tact1m4n3/eprinter/pcb/eprinter.kicad_pcb

## KiCad design pcb/eprinter.kicad_pcb (2026-11-06)

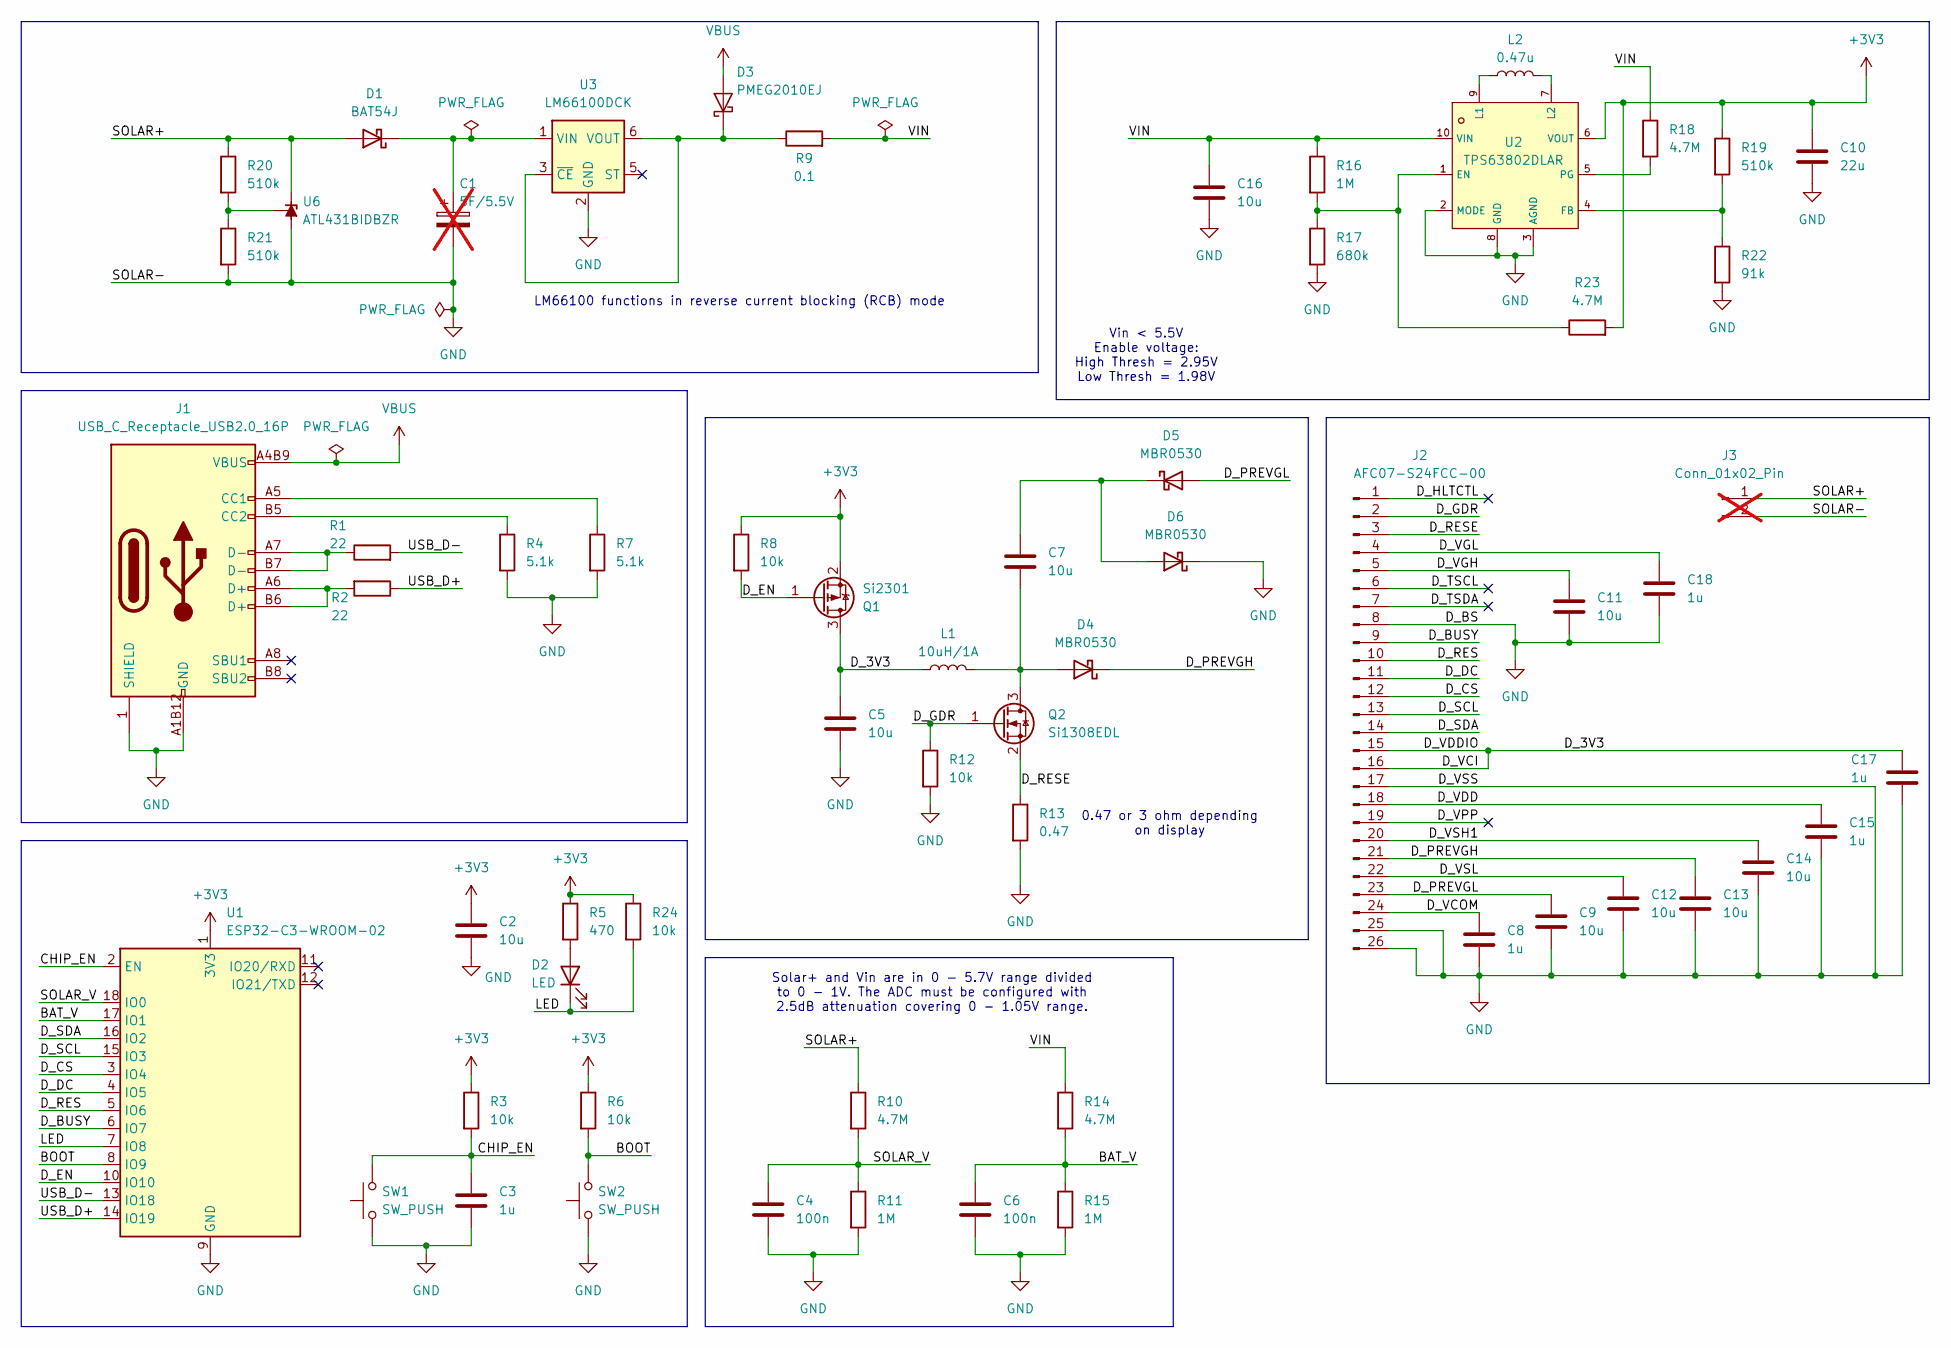
[picture p1: schematic eprinter.kicad_sch]

Parts:
C1: 5F/5.5V; THT_SUPERCAP; not fitted
C2, C5, C7, C9, C11, C12, C13, C14, C16: 10u; C_0805_2012Metric; LCSC C440198
C3, C8, C15, C17, C18: 1u; C_0603_1608Metric; LCSC C15849
C4, C6: 100n; C_0603_1608Metric; LCSC C14663
C10: 22u; C_0805_2012Metric; LCSC C45783
D1: BAT54J; D_SOD-323F; LCSC C130415
D2: LED; LED_0603_1608Metric; LCSC C2286
D3: PMEG2010EJ; D_SOD-323F; LCSC C552826
D4, D5, D6: MBR0530; D_SOD-123; LCSC C82046
J1: USB_C_Receptacle_USB2.0_16P; USB-C_SMD-TYPE-C-31-M-12_1; LCSC C165948
J2: AFC07-S24FCC-00; FPC-SMD_AFC07-S24FCC-00; LCSC C11057
J3: Conn_01x02_Pin; PinHeader_1x02_P2.54mm_Vertical; not fitted
L1: 10uH/1A; IND-SMD_L4.0-W4.0; LCSC C2849464
L2: 0.47u; L_1210_3225Metric; LCSC C89029
Q1: Si2301; SOT-23; LCSC C10487
Q2: Si1308EDL; SOT-323_SC-70; LCSC C469327
R1, R2: 22; R_0603_1608Metric; LCSC C23345
R3, R6, R8, R12, R24: 10k; R_0603_1608Metric; LCSC C25804
R4, R7: 5.1k; R_0603_1608Metric; LCSC C23186
R5: 470; R_0603_1608Metric; LCSC C23179
R9: 0.1; R_0603_1608Metric; LCSC C844273
R10, R14, R18, R23: 4.7M; R_0603_1608Metric; LCSC C23163
R11, R15, R16: 1M; R_0603_1608Metric; LCSC C22935
R13: 0.47; R_0603_1608Metric; LCSC C23411
R17: 680k; R_0603_1608Metric; LCSC C25822
R19, R20, R21: 510k; R_0603_1608Metric; LCSC C23192
R22: 91k; R_0603_1608Metric; LCSC C23265
SW1, SW2: SW_PUSH; SW-SMD_L3.9-W3.0-P4.45; LCSC C720477
U1: ESP32-C3-WROOM-02; LCSC C2934560
U2: TPS63802DLAR; VSON-10_L3.0-W2.0-P0.50-TL; LCSC C2845237
U3: LM66100DCK; SOT-363_SC-70-6; LCSC C2869734
U6: ATL431BIDBZR; SOT-23-3; LCSC C701718

Connections:
+3V3: C2.1, C10.1, Q1.2 (S), R3.1, R5.1, R6.1, R8.1, R19.1, R23.2, R24.1, U1.1 (3V3), U2.6 (VOUT)
/BAT_V: C6.1, R14.2, R15.1, U1.17 (IO1)
/BOOT: R6.2, SW2.2, U1.8 (IO9)
/CHIP_EN: C3.1, R3.2, SW1.2, U1.2 (EN)
/D_3V3: C5.1, C17.1, J2.15, J2.16, L1.1, Q1.3 (D)
/D_BUSY: J2.9, U1.6 (IO7)
/D_CS: J2.12, U1.3 (IO4)
/D_DC: J2.11, U1.4 (IO5)
/D_EN: Q1.1 (G), R8.2, U1.10 (IO10)
/D_GDR: J2.2, Q2.1 (G), R12.1
/D_HLTCTL: J2.1
/D_PREVGH: C13.1, D4.1 (K), J2.21
/D_PREVGL: C9.1, D5.2 (A), J2.23
/D_RES: J2.10, U1.5 (IO6)
/D_RESE: J2.3, Q2.2 (S), R13.1
/D_SCL: J2.13, U1.15 (IO3)
/D_SDA: J2.14, U1.16 (IO2)
/D_TSCL: J2.6
/D_TSDA: J2.7
/D_VCOM: C8.1, J2.24
/D_VDD: C15.1, J2.18
/D_VGH: C11.1, J2.5
/D_VGL: C18.1, J2.4
/D_VPP: J2.19
/D_VSH1: C14.1, J2.20
/D_VSL: C12.1, J2.22
/LED: D2.1 (K), R24.2, U1.7 (IO8)
/SOLAR+: D1.2 (A), J3.1, R10.1, R20.1, U6.1 (K)
/SOLAR_V: C4.1, R10.2, R11.1, U1.18 (IO0)
/USB_5V: D3.2 (A), J1.A4B9 (VBUS), J1.B4A9 (VBUS)
/USB_D+: R2.1, U1.14 (IO19)
/USB_D-: R1.2, U1.13 (IO18)
/VIN: C16.1, R9.2, R14.1, R16.1, R18.1, U2.10 (VIN)
GND: C1.2, C2.2, C3.2, C4.2, C5.2, C6.2, C8.2, C9.2, C10.2, C11.2, C12.2, C13.2, C14.2, C15.2, C16.2, C17.2, C18.2, D6.1 (K), J1.1 (SHIELD), J1.2 (SHIELD), J1.3 (SHIELD), J1.4 (SHIELD), J1.A1B12 (GND), J1.B1A12 (GND), J2.8, J2.17, J2.25, J2.26, J3.2, R4.2, R7.2, R11.2, R12.2, R13.2, R15.2, R17.2, R21.2, R22.2, SW1.1, SW2.1, U1.9 (GND), U1.19 (GND), U2.2 (MODE), U2.3 (AGND), U2.8 (GND), U3.2 (GND), U6.3 (A)
unnamed: C1.1, D1.1 (K), U3.1 (VIN)
unnamed: D2.2 (A), R5.2
unnamed: D3.1 (K), R9.1, U3.3 (~CE), U3.6 (VOUT)
unnamed: C7.2, D4.2 (A), L1.2, Q2.3 (D)
unnamed: C7.1, D5.1 (K), D6.2 (A)
unnamed: J1.A5 (CC1), R7.1
unnamed: J1.B5 (CC2), R4.1
unnamed: J1.A6 (D+), J1.B6 (D+), R2.2
unnamed: J1.A7 (D-), J1.B7 (D-), R1.1
unnamed: R16.2, R17.1, R23.1, U2.1 (EN)
unnamed: R19.2, R22.1, U2.4 (FB)
unnamed: L2.1, U2.9 (L1)
unnamed: L2.2, U2.7 (L2)
unnamed: R18.2, U2.5 (PG)
unnamed: R20.2, R21.1, U6.2 (REF)

Notes on the sheet:
Vin < 5.5V Enable voltage: High Thresh = 2.95V Low Thresh = 1.98V
LM66100 functions in reverse current blocking (RCB) mode
0.47 or 3 ohm depending on display
Solar+ and Vin are in 0 - 5.7V range divided to 0 - 1V. The ADC must be configured with 2.5dB attenuation covering 0 - 1.05V range.

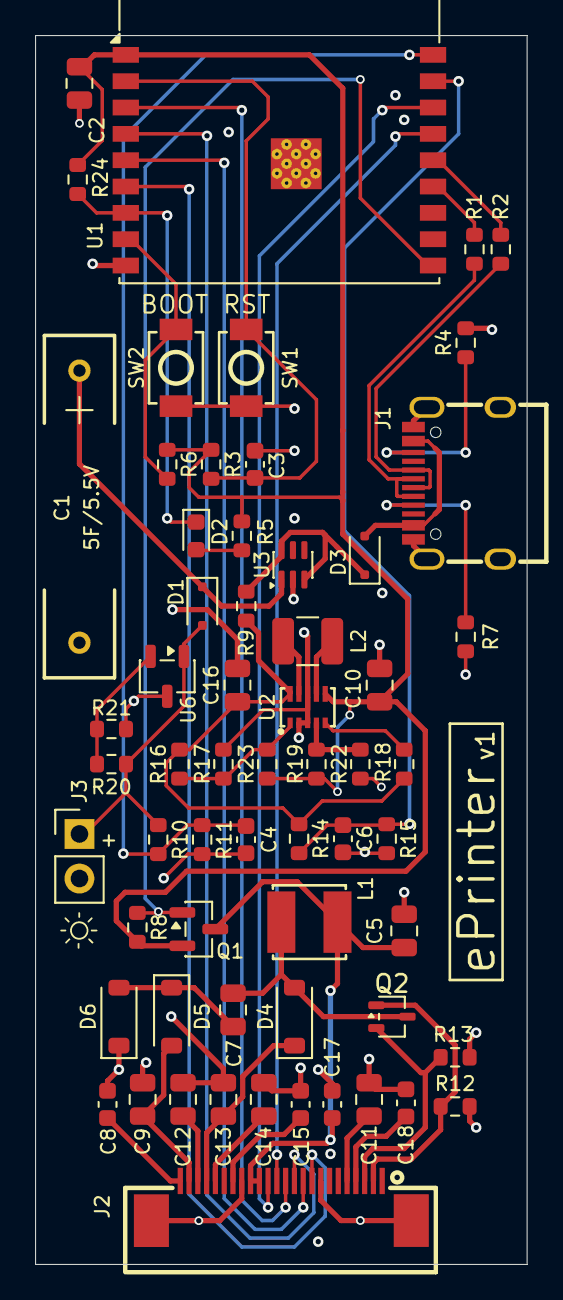
[picture p2: board eprinter.kicad_pcb from above]

Board: 4 copper layers, 28.0 x 70.0 mm, 61 parts (0 on the bottom side), 45 nets.
