tact1m4n3/eprinter/(commit log)

2026-09-27 PCB schematic first steps
    [eprinter.kicad_pcb, eprinter.kicad_sch]
2026-09-28 PCB design work
    [eprinter.kicad_pcb, eprinter.kicad_sch]
2026-09-29 Finish PCB routing
    [eprinter.kicad_pcb]
2026-09-30 Refactor PCB
    [eprinter.kicad_pcb, eprinter.kicad_sch]
2026-10-01 Finalize silk screen
    [eprinter.kicad_pcb, eprinter.kicad_sch]
2026-10-02 Display driver schematic
    [eprinter.kicad_sch]
2026-10-02 Schematic verification
    [eprinter.kicad_pcb, eprinter.kicad_sch]
2026-10-02 Routing done
    [eprinter.kicad_pcb, eprinter.kicad_sch]
2026-10-03 PCB silkscreen done and LCSC part selection
    [eprinter.kicad_pcb, eprinter.kicad_sch]
2026-10-03 Finalize JLCPCB order
    [eprinter.kicad_pcb, eprinter.kicad_sch]
2026-10-11 Finish PCB v1
2026-10-25 Switch to buck-boost converter to utilize more super cap capacity
2026-11-06 Fix schematic
2026-11-06 Finish pcb
